lla7wel/Pico-AI-Agentic-System/(commit log)

2026-07-06 Initial build: Pico W retro voice agent (backend + firmware)
    Backend (FastAPI + WebSockets, Fly.io):
    - Auth-gated wss endpoint; one long-lived connection per device carrying
    many push-to-talk turns
    - Live PCM -> Deepgram Nova-3 streaming STT -> Claude with last-10-turn
    SQLite memory -> reply streamed back; raw audio never persisted
    - Docker + fly.toml (warm machine + persistent volume), DEPLOY.md
    - Verified offline via test_flow_mock.py (auth, multi-turn memory,
    PCM forwarding, bad-auth rejection)
    Firmware (arduino-pico):
    - Custom PIO I2S receiver for the direct-plugged SPH0645 (GP19/20/21 on
    independent pin groups); all 8 instruction encodings machine-verified
    - Continuous DMA writ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
2026-07-06 Refactor backend into an agent platform: OpenAI + web dashboard
    Direction change: the Pico stays a thin voice terminal (unchanged wire
    protocol and firmware). The backend becomes a runtime-configurable agent
    platform driven by a web dashboard — no more editing code/.env/config.
    LLM:
    - Replace Anthropic with OpenAI behind a provider interface (app/llm/)
    with function/tool-calling support
    - Model, temperature, prompt, response length all dashboard-configurable
    Runtime config + admin:
    - Settings store in SQLite (secrets masked on read; blank never wipes a key)
    - Admin login (PBKDF2, bearer sessions), password change
    - Device registry with generated tokens (copy into secrets.h), rotate/del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
2026-07-07 Final cleanup for public release
    - Remove dev-process comments (project-brief references, stale AI
    mentions) and fix garbled docstrings; keep technical notes intact
    - Remove dead code (presence.snapshot); wire destroy_session into
    /api/logout; drop unused python-multipart dependency
    - Add backend/run.sh for one-command local start
    - Rewrite root README (architecture, setup, dashboard, troubleshooting)
    and clean up firmware README + DEPLOY.md
    - Add MIT LICENSE; tighten .gitignore; untrack .claude/launch.json
    - Firmware also gains ws:// support for local dev (WS_USE_TLS) and
    serial diagnostics for WiFi/WS bring-up
    Verified: firmware compiles (arduino-cli, RP2040 core), backend test
    su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
    [TFT_eSPI_User_Setup.h, ca_cert.h, config.h, display.cpp, pico_i2s.cpp, pico_i2s.h]
2026-07-07 Add hardware docs, wiring schematic, and product showcase
    - docs/HARDWARE.md: component-level bill of materials, per-subsystem
    wiring tables, power and memory design notes
    - docs/images/wiring-diagram.svg: full wiring schematic (Pico W, TFT,
    SPH0645 mic, buttons, LED, buzzer)
    - docs/SHOWCASE.md: photo-documented product walkthrough with image
    placeholders, specs, engineering highlights, and roadmap
    - Describe hardware as discrete hand-wired components throughout;
    README hardware section now links the new docs
    [TFT_eSPI_User_Setup.h, config.h]
2026-07-09 Add device photos to the showcase and README
    Boot sequence, ready prompt, listening state, and a live response —
    rotated upright and wired into docs/SHOWCASE.md; hero shot embedded in
    the README. Remaining photo slots left as commented placeholders so
    nothing renders broken.
